StefanHamminga/StepperDriverModuleCarrier/StepperDriverModuleCarrier1.png

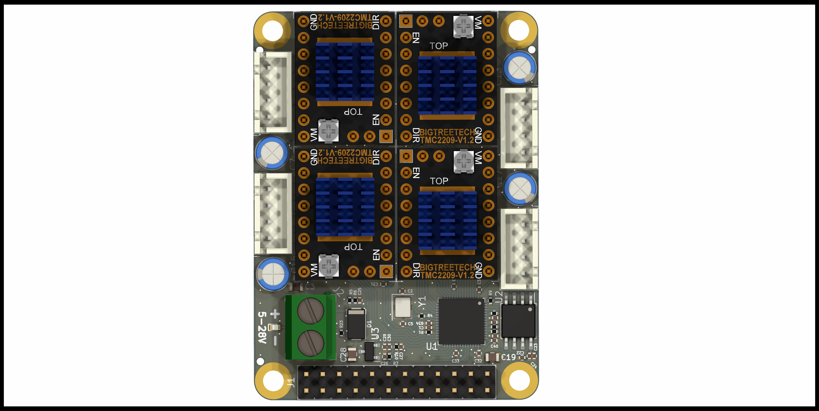
StepperDriverModuleCarrier1.png
