StefanHamminga/StepperDriverModuleCarrier/Review/3d.png

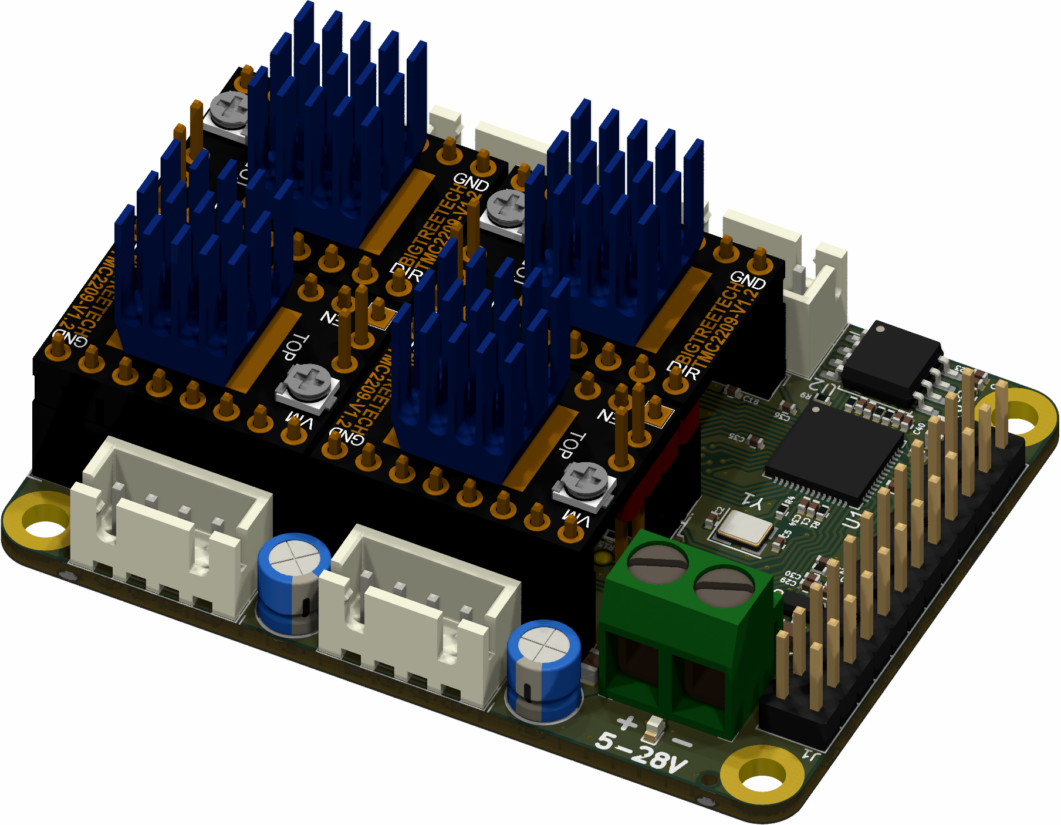
Review/3d.png
