StefanHamminga/StepperDriverModuleCarrier/README.md

# StepperDriverModuleCarrier

RP2040 based carrier board for 4 TMC2209 stepper motor driver module boards (as used in 3D printer controllers)
