StefanHamminga/StepperDriverModuleCarrier/Review/Back.png

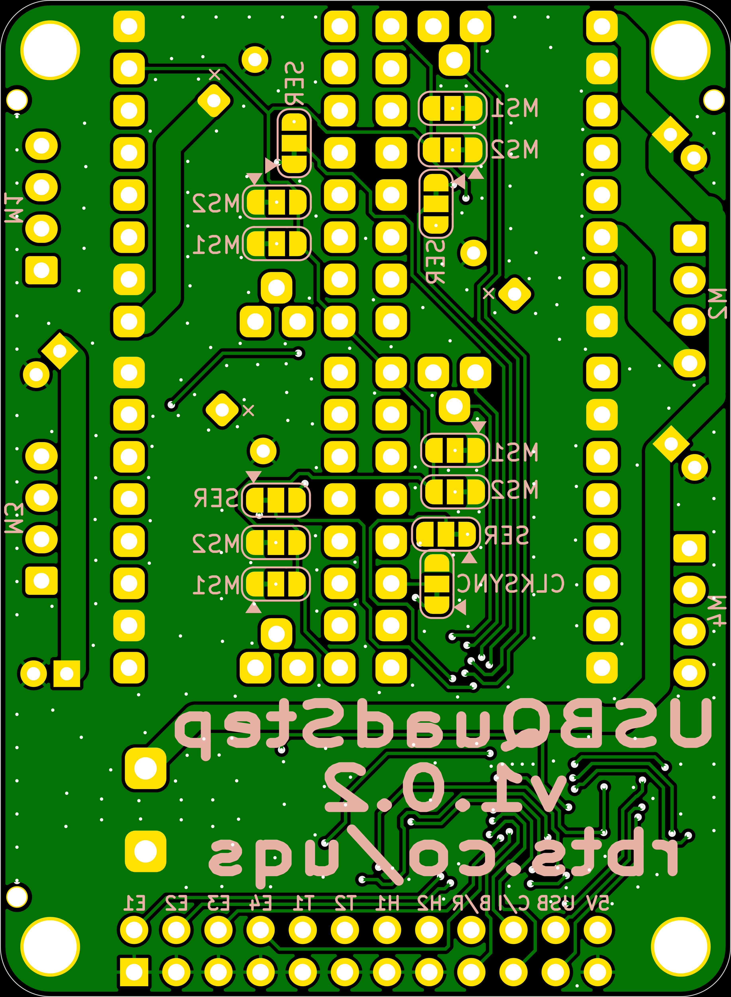
Review/Back.png
