StefanHamminga/StepperDriverModuleCarrier/Review/Front.png

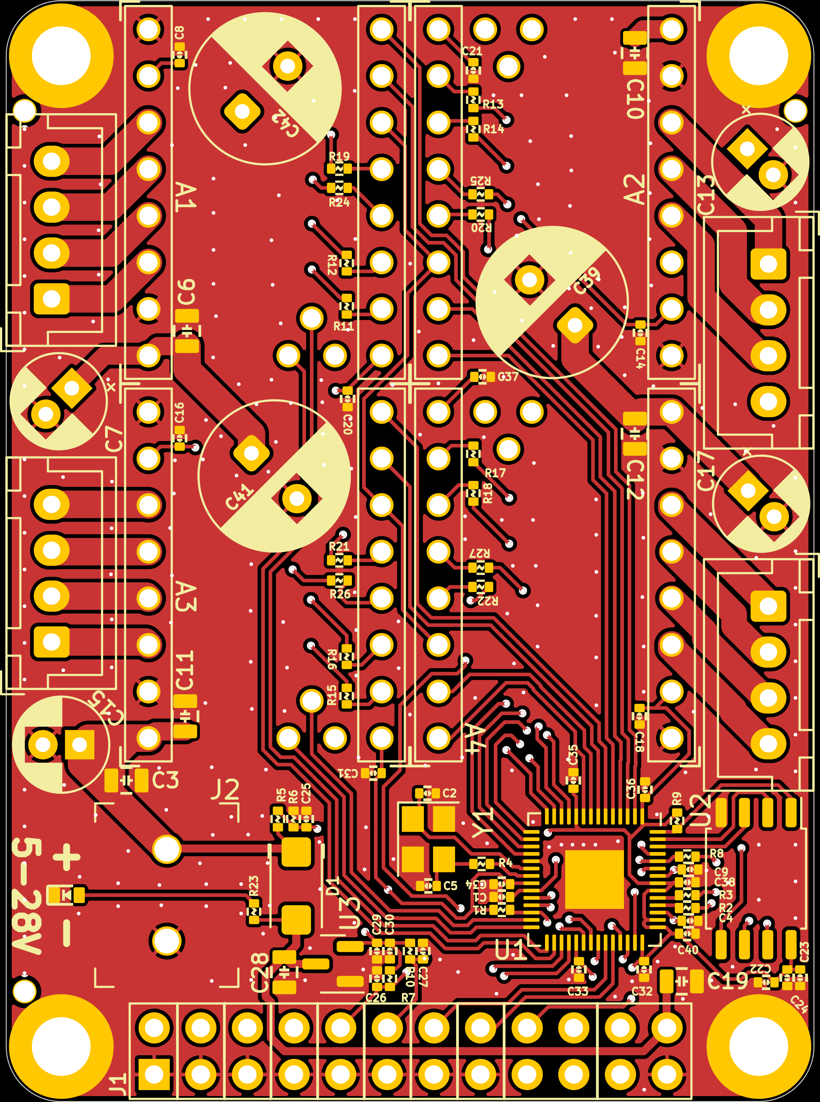
Review/Front.png
