StefanHamminga/StepperDriverModuleCarrier/Review/Schematic.png

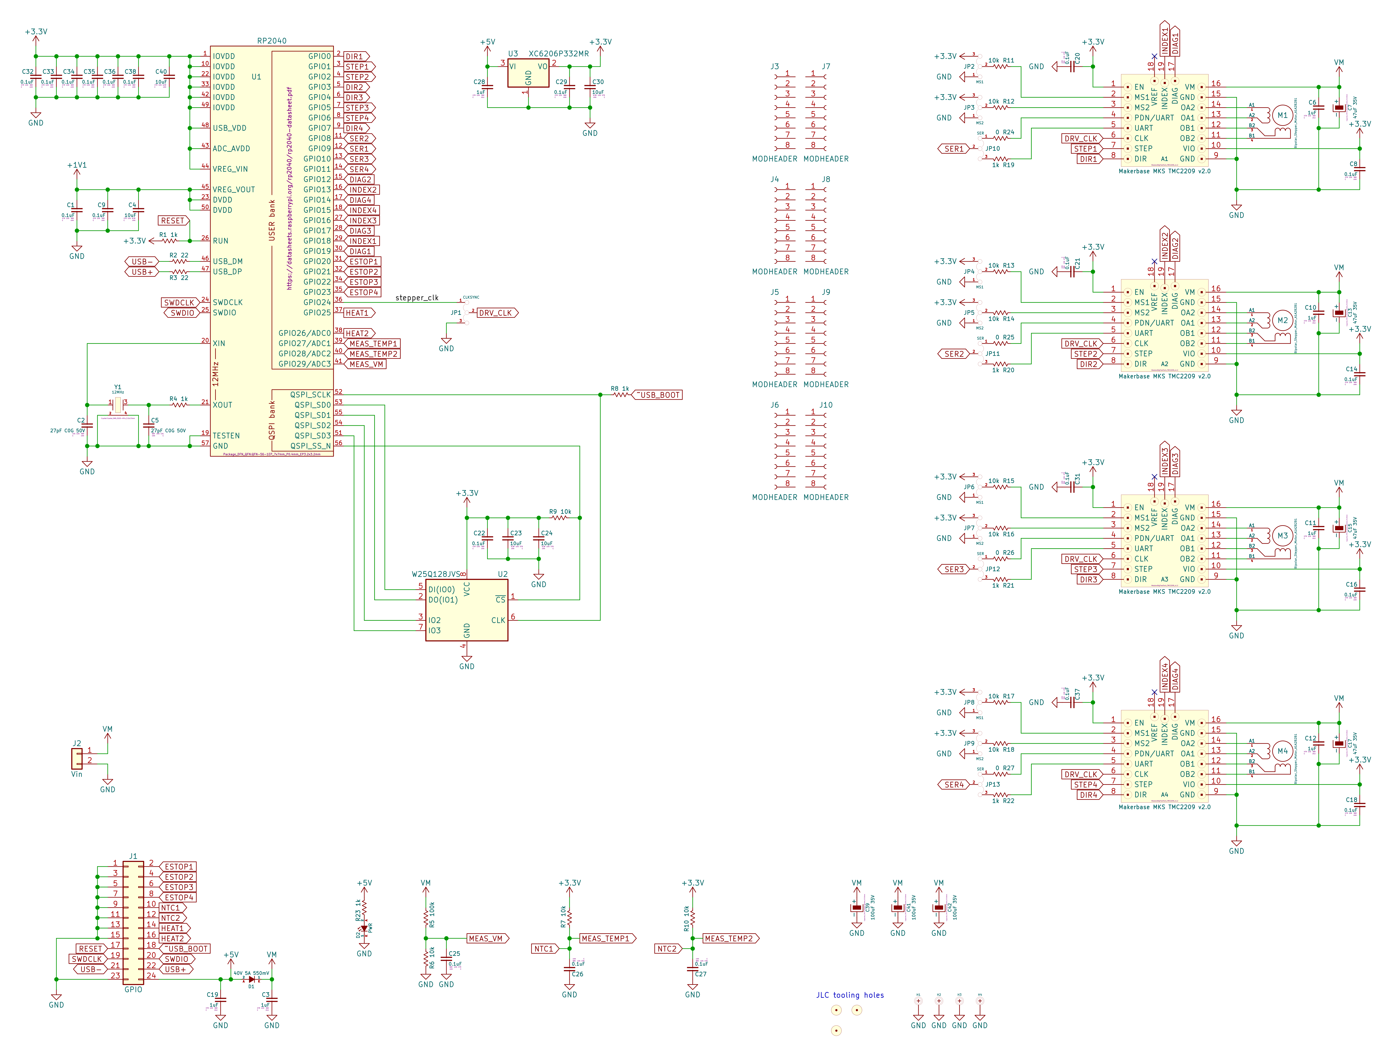
Review/Schematic.png
