StefanHamminga/StepperDriverModuleCarrier/StepperDriverModuleCarrier2.png

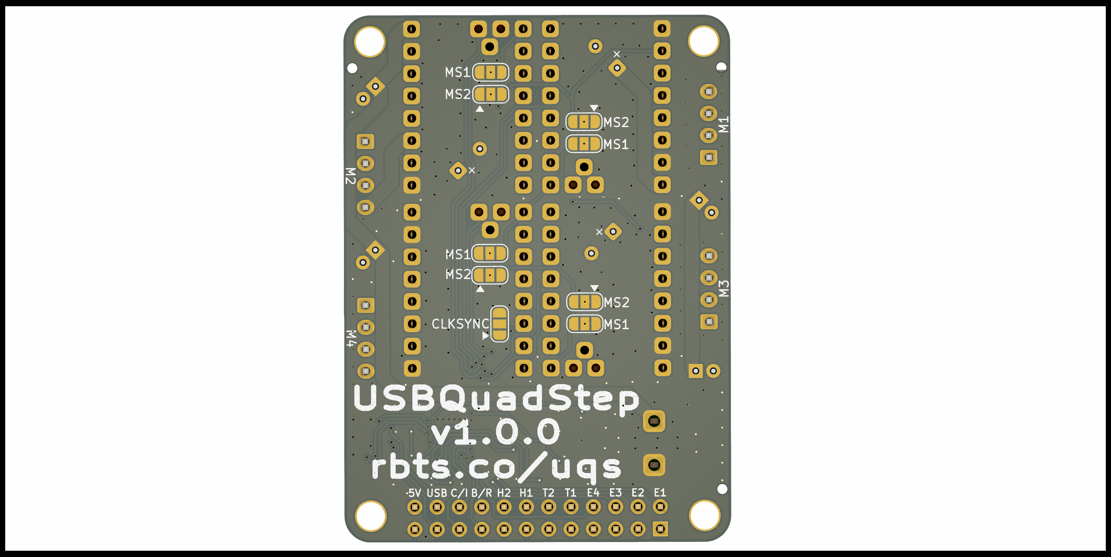
StepperDriverModuleCarrier2.png
