StefanHamminga/StepperDriverModuleCarrier/StepperDriverModuleCarrier3.png

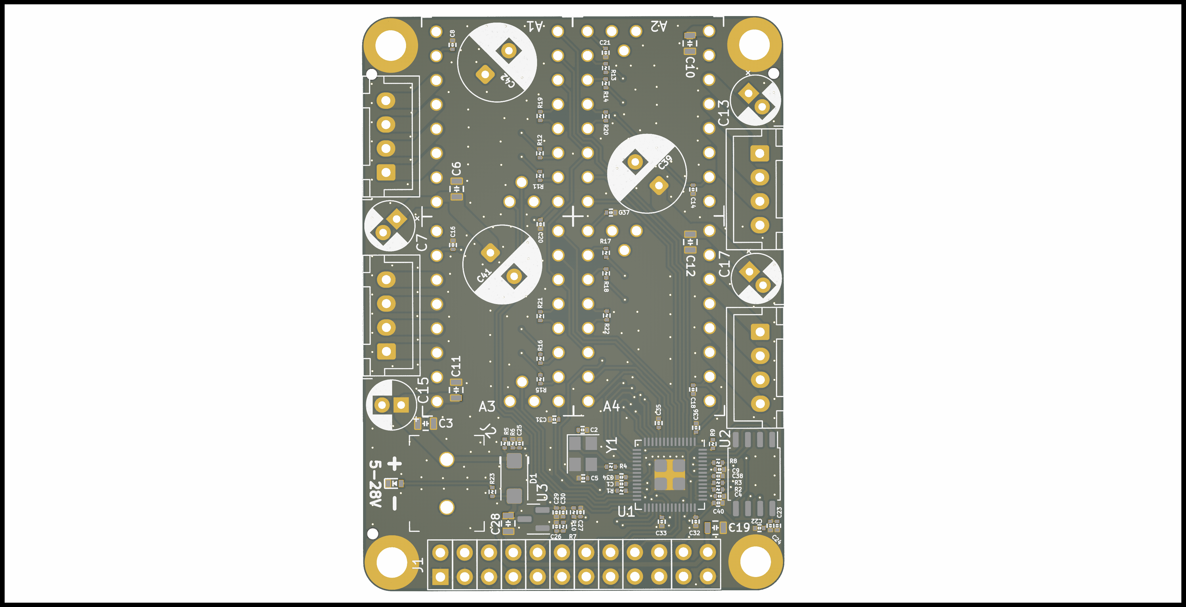
StepperDriverModuleCarrier3.png
