StefanHamminga/StepperDriverModuleCarrier/StepperDriverModuleCarrier4.png

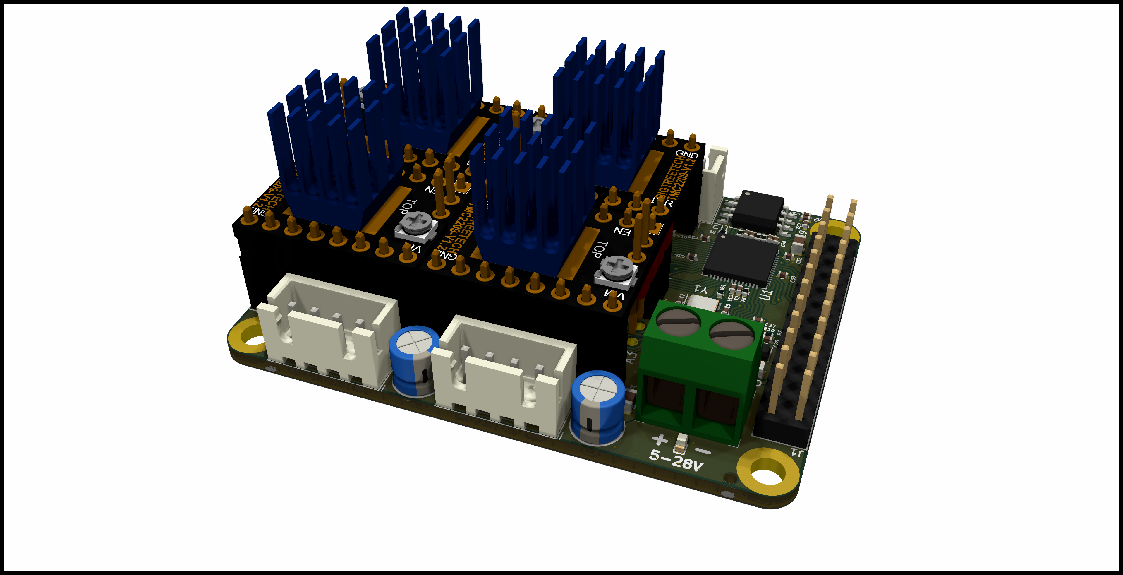
StepperDriverModuleCarrier4.png
