StefanHamminga/StepperDriverModuleCarrier/CAM/StepperDriverModuleCarrier-B_Cu.dxf

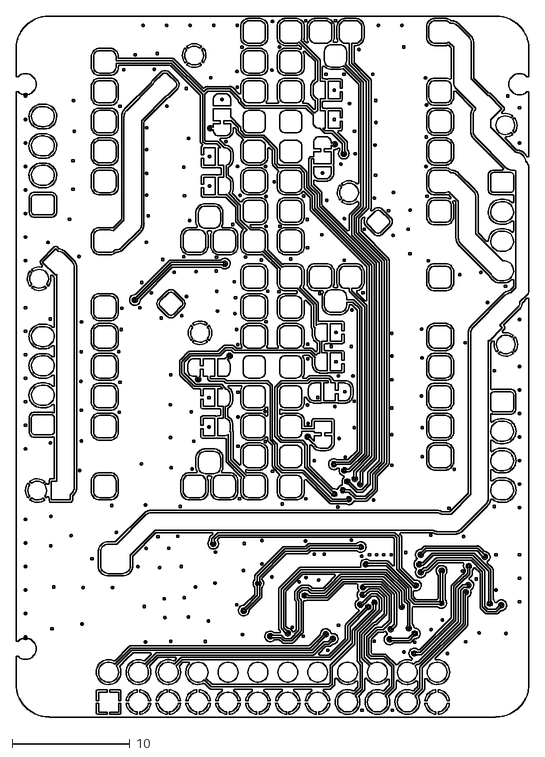
[picture p9: CAD file, 2022-01-12]
CAM/StepperDriverModuleCarrier-B_Cu.dxf
43.6 x 59.6
