StefanHamminga/StepperDriverModuleCarrier/CAM/StepperDriverModuleCarrier-F_Fab.dxf

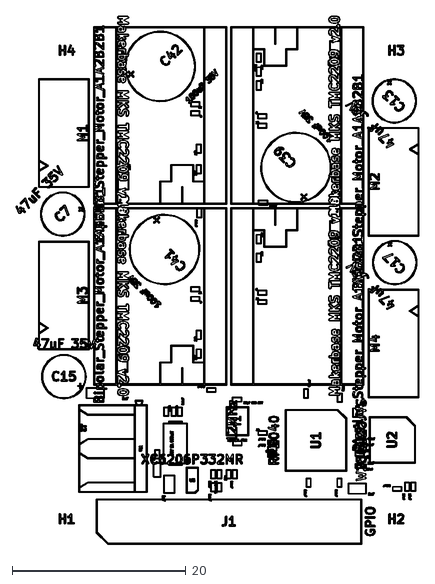
[picture p10: CAD file, 2022-01-12]
CAM/StepperDriverModuleCarrier-F_Fab.dxf
46.4 x 60.9
