StefanHamminga/StepperDriverModuleCarrier/CAM/StepperDriverModuleCarrier-Edge_Cuts.dxf

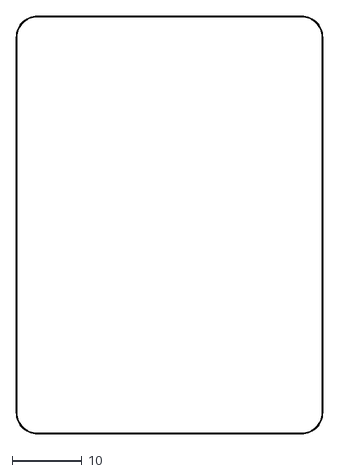
[picture p11: CAD file, 2022-01-12]
CAM/StepperDriverModuleCarrier-Edge_Cuts.dxf
44.1 x 60.1
