StefanHamminga/StepperDriverModuleCarrier/CAM/StepperDriverModuleCarrier-F_Cu.dxf

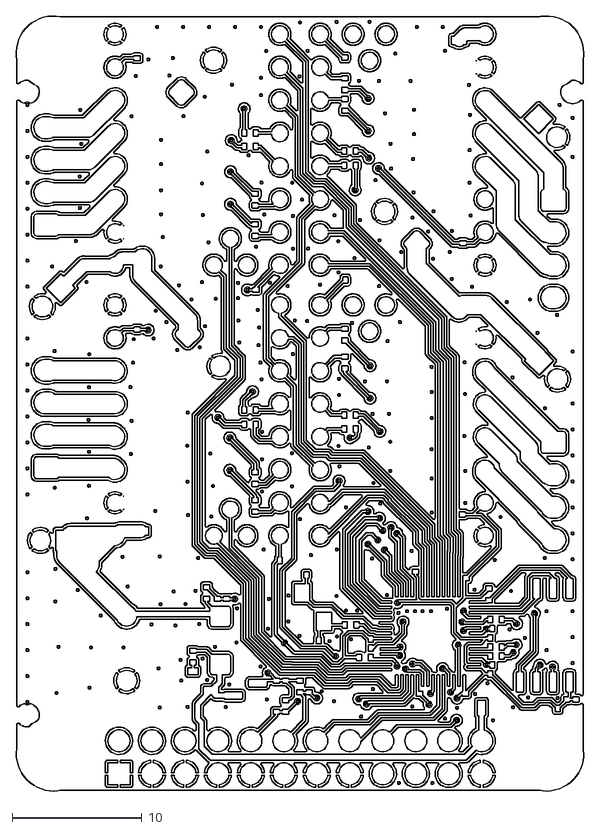
[picture p12: CAD file, 2022-01-12]
CAM/StepperDriverModuleCarrier-F_Cu.dxf
43.7 x 59.7
