StefanHamminga/StepperDriverModuleCarrier/(list of files, cad)

Other CAD files:
CAM/StepperDriverModuleCarrier-B_Mask.dxf
CAM/StepperDriverModuleCarrier-B_Paste.dxf
CAM/StepperDriverModuleCarrier-B_Silkscreen.dxf
CAM/StepperDriverModuleCarrier-F_Mask.dxf
CAM/StepperDriverModuleCarrier-F_Paste.dxf
CAM/StepperDriverModuleCarrier-F_Silkscreen.dxf
