StefanHamminga/StepperDriverModuleCarrier/StepperDriverModuleCarrier.kicad_pcb

## KiCad design StepperDriverModuleCarrier.kicad_pcb (2022-01-12)

Schematic: StepperDriverModuleCarrier.kicad_sch

Parts:
A1, A2, A3, A4: Makerbase MKS TMC2209 v2.0; BigTreeTech_TMC2209_v1.2
C1, C8, C9, C14, C16, C18, C20, C21, C22, C25, C26, C27, C29, C31, C32, C33, C34, C35, C36, C37, C38: 0.1uF; 1005_C; Voltage 50V; Tolerance 10%; MPN CL05B104KO5NNNC; JLCPCB Part C1525
C2, C5: 27pF C0G 50V; 1005_C; Voltage 50V; Tolerance 10%; MPN 0402CG270J500NT; JLCPCB Part C1557
C3, C6, C10, C11, C12, C19, C28: 1uF; 2012_C; Voltage 50V; Tolerance 10%; MPN CL21B105KBFNNNE; JLCPCB Part C28323
C4, C23, C24, C30, C40: 10uF; 1005_C; Voltage 6.3V; Tolerance 10%; MPN CL05A106MQ5NUNC; JLCPCB Part C15525
C7, C13, C15, C17: 47uF 35V; CP_Radial_D5.0mm_P2.00mm; MPN RG035M470LO5*11TA-1A1E; JLCPCB Part C357615
C39, C41, C42: 100uF 35V; CP_Radial_D8.0mm_P3.50mm; MPN NPHDD1H101MF; JLCPCB Part C269987
D1: 40V 5A 550mV; DO-214AC_KA; MPN SS54; JLCPCB Part C22452
D2: PWR; 1608_C_KA; MPN 19-217/GHC-YR1S2/3T; JLCPCB Part C72043
FD1, FD2, FD3: FIDUCIAL_MARKER; ToolingHole_JLCPCB_1.152mm; MPN DNP
H1, H2, H3, H4: MOUNT_HOLE; MountingHole_3.2mm_M3_ISO7380_Pad_TopOnly; MPN DNP
J1: GPIO; PinHeader_2x12_P2.54mm_Vertical; MPN PZ254V-12-24P; JLCPCB Part C492429
J2: Vin; Ningbo_Kangnex_Electric_WJ126V-5.0-2P; MPN WJ126V-5.0-2P; JLCPCB Part C8404
J3, J4, J5, J6, J7, J8, J9, J10: MODHEADER; Dummy_01x08_2.54mm_header; MPN C27438; JLCPCB Part C27438
JP1: CLKSYNC; SolderJumper-3_P1.3mm_Bridged12_RoundedPad1.0x1.5mm_NumberL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; MPN DNP
JP2, JP4, JP6, JP8: MS1; SolderJumper-3_P1.3mm_Bridged12_RoundedPad1.0x1.5mm_NumberL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; MPN DNP
JP3, JP5, JP7, JP9: MS2; SolderJumper-3_P1.3mm_Bridged12_RoundedPad1.0x1.5mm_NumberL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; MPN DNP
JP10, JP11, JP12, JP13: SER; SolderJumper-3_P1.3mm_Bridged12_RoundedPad1.0x1.5mm_NumberL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; MPN DNP
M1, M2, M3, M4: Bipolar_Stepper_Motor_A1A2B2B1; JST_XH_B4B-XH-A_1x04_P2.50mm_Vertical; MPN XH-4A; JLCPCB Part C57846
R1, R4, R8, R19, R20, R21, R22, R23: 1k; 1005_C; MPN 0402WGF1001TCE; JLCPCB Part C11702
R2, R3: 22; 1005_C; MPN 0402WGF220JTCE; JLCPCB Part C25092
R5: 100k; 1005_C; MPN 0402WGF1003TCE; JLCPCB Part C25741
R6, R7, R9, R10, R11, R12, R13, R14, R15, R16, R17, R18: 10k; 1005_C; MPN 0402WGF1002TCE; JLCPCB Part C25744
R24, R25, R26, R27: 0; 1005_C; MPN 0402WGF0000TCE; JLCPCB Part C17168
U1: RP2040; QFN-56-1EP_7x7mm_P0.4mm_EP3.2x3.2mm; MPN RP2040; JLCPCB Part C2040
U2: W25Q128JVS; SOIC-8_5.23x5.23mm_P1.27mm; MPN W25Q128JVSIQ; JLCPCB Part C97521
U3: XC6206P332MR; SOT-23; MPN XC6206P332MR; JLCPCB Part C5446
Y1: 12MHz; Crystal_SMD_3225-4Pin_3.2x2.5mm; MPN X322512MSB4SI; JLCPCB Part C9002

Connections:
+1V1: C1.1, C4.1, C9.1, U1.23 (DVDD), U1.45 (VREG_VOUT), U1.50 (DVDD)
+3V3: A1.1 (EN), A1.10 (VIO), A2.1 (EN), A2.10 (VIO), A3.1 (EN), A3.10 (VIO), A4.1 (EN), A4.10 (VIO), C8.1, C14.1, C16.1, C18.1, C20.1, C21.1, C22.1, C23.1, C24.1, C29.1, C30.1, C31.1, C32.1, C33.1, C34.1, C35.1, C36.1, C37.1, C38.1, C40.1, JP2.3, JP3.3, JP4.3, JP5.3, JP6.3, JP7.3, JP8.3, JP9.3, R1.2, R7.1, R9.2, R10.1, U1.1 (IOVDD), U1.10 (IOVDD), U1.22 (IOVDD), U1.33 (IOVDD), U1.42 (IOVDD), U1.43 (ADC_AVDD), U1.44 (VREG_VIN), U1.48 (USB_VDD), U1.49 (IOVDD), U2.8 (VCC), U3.2 (VO)
+5V: C19.1, C28.1, D1.A (2), J1.24, R23.1, U3.3 (VI)
/stepper_clk: JP1.1, U1.36 (GPIO24)
DIAG1: A1.17 (DIAG), U1.30 (GPIO19)
DIAG2: A2.17 (DIAG), U1.15 (GPIO12)
DIAG3: A3.17 (DIAG), U1.28 (GPIO17)
DIAG4: A4.17 (DIAG), U1.17 (GPIO14)
DIR1: A1.8 (DIR), U1.2 (GPIO0)
DIR2: A2.8 (DIR), U1.5 (GPIO3)
DIR3: A3.8 (DIR), U1.6 (GPIO4)
DIR4: A4.8 (DIR), U1.9 (GPIO7)
DRV_CLK: A1.6 (CLK), A2.6 (CLK), A3.6 (CLK), A4.6 (CLK), JP1.2
ESTOP1: J1.2, U1.31 (GPIO20)
ESTOP2: J1.4, U1.32 (GPIO21)
ESTOP3: J1.6, U1.34 (GPIO22)
ESTOP4: J1.8, U1.35 (GPIO23)
GND: A1.9 (GND), A1.15 (GND), A2.9 (GND), A2.15 (GND), A3.9 (GND), A3.15 (GND), A4.9 (GND), A4.15 (GND), C1.2, C2.2, C3.2, C4.2, C5.2, C6.2, C7.2 (-), C8.2, C9.2, C10.2, C11.2, C12.2, C13.2 (-), C14.2, C15.2 (-), C16.2, C17.2 (-), C18.2, C19.2, C20.2, C21.2, C22.2, C23.2, C24.2, C25.2, C26.1, C27.1, C28.2, C29.2, C30.2, C31.2, C32.2, C33.2, C34.2, C35.2, C36.2, C37.2, C38.2, C39.2 (-), C40.2, C41.2 (-), C42.2 (-), D2.K (1), H1.1, H2.1, H3.1, H4.1, J1.1, J1.3, J1.5, J1.7, J1.9, J1.11, J1.13, J1.15, J1.23, J2.2, JP1.3, JP2.1, JP3.1, JP4.1, JP5.1, JP6.1, JP7.1, JP8.1, JP9.1, R6.2, U1.19 (TESTEN), U1.57 (GND), U2.4 (GND), U3.1 (GND), Y1.2 (GND), Y1.4 (GND)
HEAT1: J1.14, U1.37 (GPIO25)
HEAT2: J1.16, U1.38 (GPIO26/ADC0)
INDEX1: A1.19 (INDEX), U1.29 (GPIO18)
INDEX2: A2.19 (INDEX), U1.16 (GPIO13)
INDEX3: A3.19 (INDEX), U1.27 (GPIO16)
INDEX4: A4.19 (INDEX), U1.18 (GPIO15)
MEAS_TEMP1: C26.2, J1.10, R7.2, U1.39 (GPIO27/ADC1)
MEAS_TEMP2: C27.2, J1.12, R10.2, U1.40 (GPIO28/ADC2)
MEAS_VM: C25.1, R5.2, R6.1, U1.41 (GPIO29/ADC3)
unnamed: A1.2 (MS1), R11.2
unnamed: A1.3 (MS2), R12.2
unnamed: A1.4 (PDN/UART), R24.2
unnamed: A1.5 (UART), R19.2
unnamed: A1.11 (OB2), M1.4 (B1)
unnamed: A1.12 (OB1), M1.3 (B2)
unnamed: A1.13 (OA1), M1.2 (A2)
unnamed: A1.14 (OA2), M1.1 (A1)
unnamed: A2.4 (PDN/UART), R25.2
unnamed: A2.5 (UART), R20.2
unnamed: A2.11 (OB2), M2.4 (B1)
unnamed: A2.12 (OB1), M2.3 (B2)
unnamed: A2.13 (OA1), M2.2 (A2)
unnamed: A2.14 (OA2), M2.1 (A1)
unnamed: A3.2 (MS1), R15.2
unnamed: A3.3 (MS2), R16.2
unnamed: A3.4 (PDN/UART), R26.2
unnamed: A3.5 (UART), R21.2
unnamed: A3.11 (OB2), M3.4 (B1)
unnamed: A3.12 (OB1), M3.3 (B2)
unnamed: A3.13 (OA1), M3.2 (A2)
unnamed: A3.14 (OA2), M3.1 (A1)
unnamed: A4.2 (MS1), R17.2
unnamed: A4.3 (MS2), R18.2
unnamed: A4.4 (PDN/UART), R27.2
unnamed: A4.5 (UART), R22.2
unnamed: A4.11 (OB2), M4.4 (B1)
unnamed: A4.12 (OB1), M4.3 (B2)
unnamed: A4.13 (OA1), M4.2 (A2)
unnamed: A4.14 (OA2), M4.1 (A1)
unnamed: C2.1, U1.20 (XIN), Y1.1
unnamed: C5.1, R4.2, Y1.3
unnamed: D2.A (2), R23.2
unnamed: JP2.2, R11.1
unnamed: JP3.2, R12.1
unnamed: JP4.2, R13.1
unnamed: JP5.2, R14.1
unnamed: JP6.2, R15.1
unnamed: JP7.2, R16.1
unnamed: JP8.2, R17.1
unnamed: JP9.2, R18.1
unnamed: JP11.3, R20.1
unnamed: R2.1, U1.46 (USB_DM)
unnamed: R3.1, U1.47 (USB_DP)
unnamed: R4.1, U1.21 (XOUT)
unnamed: R8.2, U1.52 (QSPI_SCLK), U2.6 (CLK)
unnamed: R9.1, U1.56 (QSPI_SS_N), U2.1 (~CS)
unnamed: A2.2 (MS1), R13.2
unnamed: A2.3 (MS2), R14.2
unnamed: JP10.3, R19.1
unnamed: JP12.3, R21.1
unnamed: JP13.3, R22.1
unnamed: JP10.1, R24.1
unnamed: JP11.1, R25.1
unnamed: JP12.1, R26.1
unnamed: JP13.1, R27.1
unnamed: U1.51 (QSPI_SD3), U2.7 (IO3)
unnamed: U1.53 (QSPI_SD0), U2.5 (DI(IO0))
unnamed: U1.54 (QSPI_SD2), U2.3 (IO2)
unnamed: U1.55 (QSPI_SD1), U2.2 (DO(IO1))
RESET: J1.17, R1.1, U1.26 (RUN)
SER1: JP10.2, U1.12 (GPIO9)
SER2: JP11.2, U1.11 (GPIO8)
SER3: JP12.2, U1.13 (GPIO10)
SER4: JP13.2, U1.14 (GPIO11)
STEP1: A1.7 (STEP), U1.3 (GPIO1)
STEP2: A2.7 (STEP), U1.4 (GPIO2)
STEP3: A3.7 (STEP), U1.7 (GPIO5)
STEP4: A4.7 (STEP), U1.8 (GPIO6)
SWDCLK: J1.19, U1.24 (SWDCLK)
SWDIO: J1.20, U1.25 (SWDIO)
USB+: J1.22, R3.2
USB-: J1.21, R2.2
VM: A1.16 (VM), A2.16 (VM), A3.16 (VM), A4.16 (VM), C3.1, C6.1, C7.1 (+), C10.1, C11.1, C12.1, C13.1 (+), C15.1 (+), C17.1 (+), C39.1 (+), C41.1 (+), C42.1 (+), D1.K (1), J2.1, R5.1
~USB_BOOT: J1.18, R8.1

Notes on the sheet:
JLC tooling holes

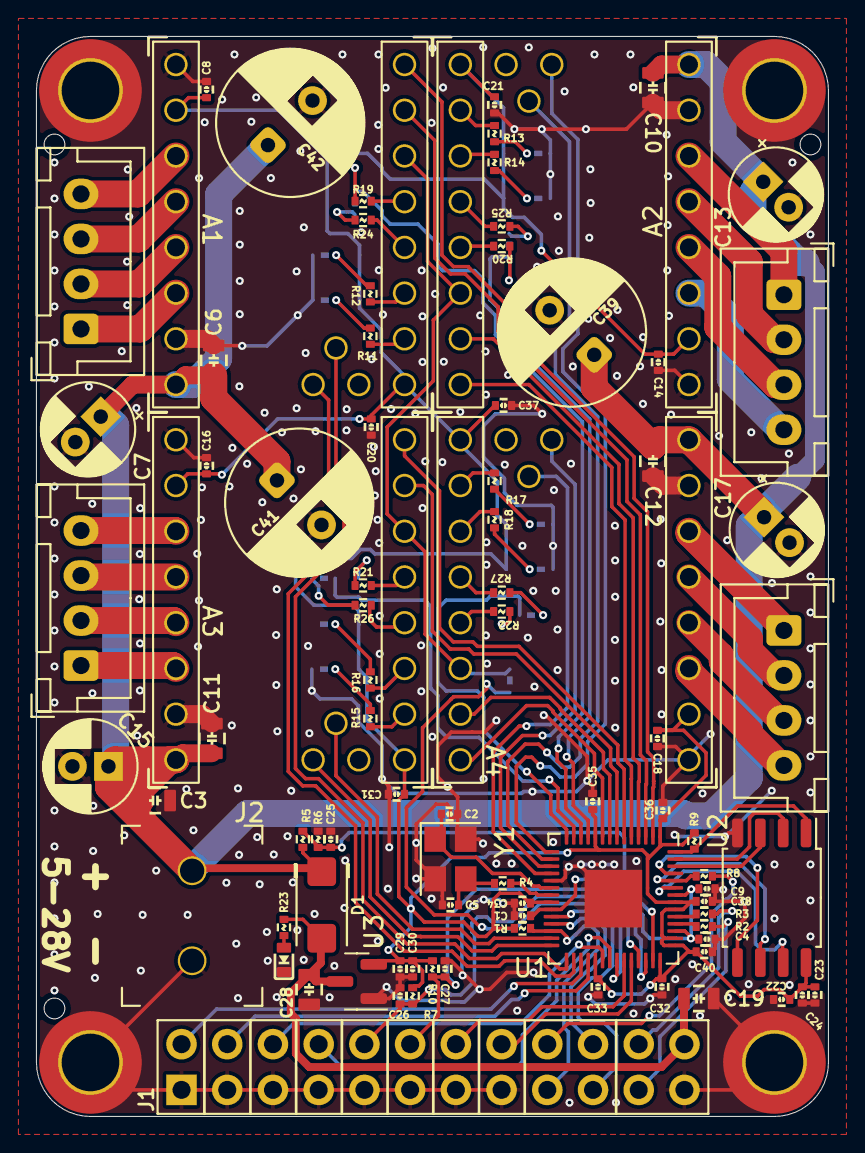
[picture p13: board StepperDriverModuleCarrier.kicad_pcb from above]

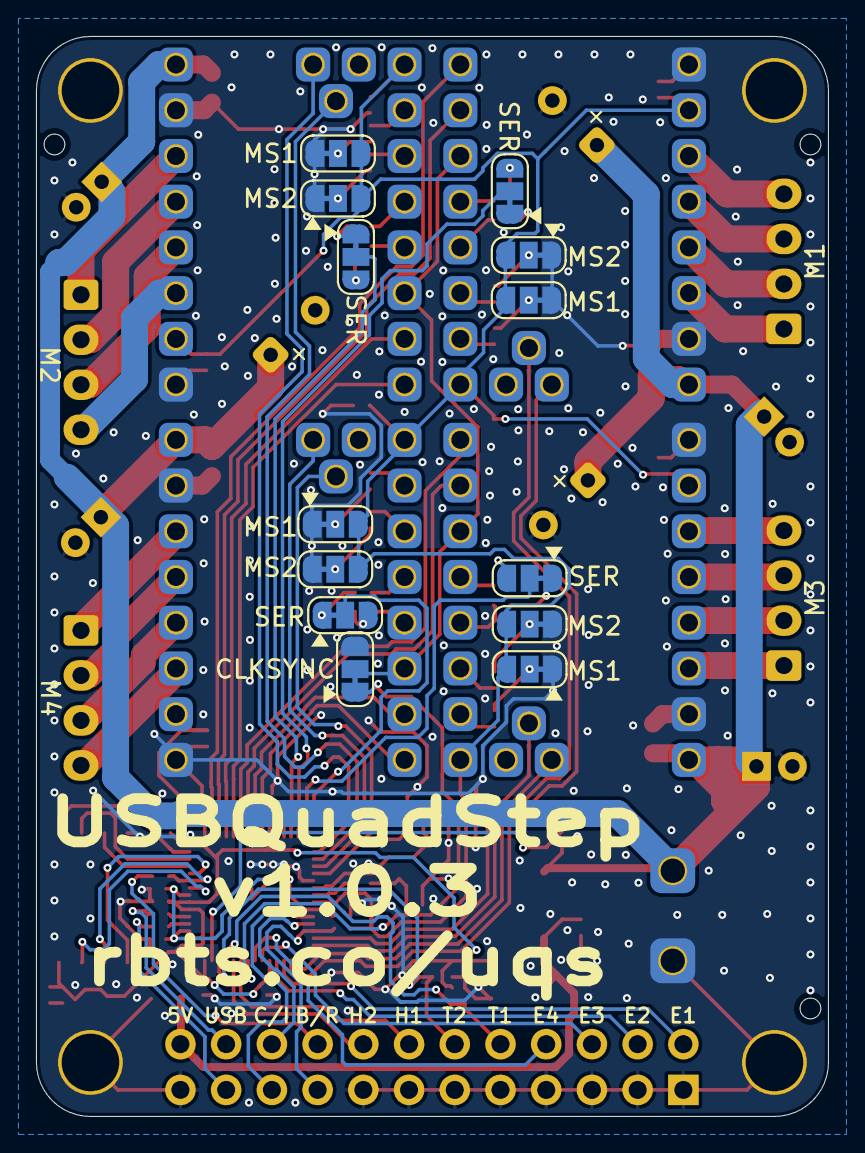
[picture p14: board StepperDriverModuleCarrier.kicad_pcb from below]

Board: 2 copper layers, 44.0 x 60.0 mm, 113 parts (13 on the bottom side), 102 nets.
